Kazn3/Case7_Exoskeleton/CAD/CAD READ ME.md

Dit README-bestand geeft een overzicht van alle CAD-iteraties van het product.
Het doel is om duidelijk te tonen welke CAD-files bij welke iteratie horen, per onderdeel.

Het product bestaat uit:
  Onderdeel A: Main_Hub
  Onderdeel B: Hand_Link
  Onderdeel C: Lower_connector
  Bijkomende parts

```
/CAD_FILES
 ├── MAIN_HUB
 │    ├── MAIN_HUB
 │    |    ├── SERVO_MINI
 │    |    |    ├── LOBE_GEAR_2
 │    |    |    └── Single row radial deep groove ball bearing ISO 1002 11 4_826
 │    |    |         └── Single row radial deep groove ball bearing ISO 1002 11 4_826_PART_1 -5
 │    |    ├── GEARBOX
 │    |    ├── Single row radial deep groove ball bearing ISO 1002 11 4_826
 │    |    |    └── Single row radial deep groove ball bearing ISO 1002 11 4_826_PART_1 -5
 │    |    ├── HOUSING
 │    |    └── Hexalobular socket cheese head screw ISO 14579 M5x45
 │    ├── MAIN_HUB_2
 │    |    ├── SERVO_MINI
 │    |    |    ├── LOBE_GEAR_2
 │    |    |    └── Single row radial deep groove ball bearing ISO 1002 11 4_826
 │    |    |         └── Single row radial deep groove ball bearing ISO 1002 11 4_826_PART_1 -5
 │    |    ├── GEARBOX_2
 │    |    ├── Single row radial deep groove ball bearing ISO 1002 11 4_826
 │    |    |    └── Single row radial deep groove ball bearing ISO 1002 11 4_826_PART_1 -5
 │    |    ├── HOUSING_2
 │    |    ├── ARDUINO_NANO
 │    |    |    └── nano-board_step
 │    |    ├── HOUSING_2
 │    |    ├── BATTERY_3.7V
 │    |    ├── ARM
 │    |    ├── PCB
 │    |    ├── SPACER
 │    |    ├── Hexagon socket countersunk head screw ISO 10642 M5x16
 │    |    ├── Hexagon socket countersunk head screw ISO 10642 M5x45
 │    |    └── Hexalobular socket cheese head screw ISO 14579 M5x45
 │    ├── MAIN_HUB_3
 │    |    ├── SERVO_MINI
 │    |    |    ├── LOBE_GEAR_2
 │    |    |    └── Single row radial deep groove ball bearing ISO 1002 11 4_826
 │    |    |         └── Single row radial deep groove ball bearing ISO 1002 11 4_826_PART_1 -5
 │    |    ├── Single row radial deep groove ball bearing ISO 1002 11 4_826
 │    |    |    └── Single row radial deep groove ball bearing ISO 1002 11 4_826_PART_1 -5
 │    |    ├── PULLEY_MG
 │    |    |    ├── PULLEY_LINK_2
 │    |    |    └── SERVO_MINI
 │    |    |         ├── LOBE_GEAR_2
 │    |    |         └── Single row radial deep groove ball bearing ISO 1002 11 4_826
 │    |    |              └── Single row radial deep groove ball bearing ISO 1002 11 4_826_PART_1 -5
 │    |    ├── ROPE
 │    |    └── Hexalobular socket cheese head screw ISO 14579 M5x45
 │    ├── MAIN_HUB_4
 │    |    ├── SERVO_MINI
 │    |    |    ├── LOBE_GEAR_2
 │    |    |    └── Single row radial deep groove ball bearing ISO 1002 11 4_826
 │    |    |         └── Single row radial deep groove ball bearing ISO 1002 11 4_826_PART_1 -5
 │    |    ├── Single row radial deep groove ball bearing ISO 1002 11 4_826
 │    |    |    └── Single row radial deep groove ball bearing ISO 1002 11 4_826_PART_1 -5
 │    |    ├── Hexagon socket countersunk head screw ISO 10642 M5x16
 │    |    └── Hexagon socket countersunk head screw ISO 10642 M5x45
 │    ├── MAIN_HUB_5
 │    |    ├── SERVO
 │    |    |    ├── LEVER_CONNECTOR
 │    |    |    ├── LEVER
 │    |    |    ├── LEVER_2
 │    |    |    ├── Single row radial deep groove ball bearing ISO 1002 11 4_826
 │    |    |    |    └── Single row radial deep groove ball bearing ISO 1002 11 4_826_PART_1 -5
 │    |    |    └── LOBE_GEAR_2
 │    |    ├── CONNECTOR
 │    |    └── Hexagon socket countersunk head screw ISO 10642 M5x45
 │    └── MAIN_HUB_6
 │    |    ├── SERVO
 │    |    |    ├── LEVER_CONNECTOR
 │    |    |    ├── LEVER
 │    |    |    ├── LEVER_2
 │    |    |    ├── Single row radial deep groove ball bearing ISO 1002 11 4_826
 │    |    |    |    └── Single row radial deep groove ball bearing ISO 1002 11 4_826_PART_1 -5
 │    |    |    └── LOBE_GEAR_2
 │    |    ├── TOP_SHELL
 │    |    ├── BACK_PART
 │    |    ├── FRONT_PART
 │    |    ├── BATTERY_MOUNT
 │    |    └── Hexagon socket countersunk head screw ISO 10642 M5x45
 ├── LOWER_CONNECTOR
 │    └── Iteratie_01: LOWER_CONNECTOR
 ├── HAND_LINK
 |    ├── HAND_LINK
 |    ├── HAND_LINK_2
 |    ├── HAND_LINK_3
 |    ├── HAND_LINK_4
 |    ├── HAND_LINK_5
 |    ├── HAND_LINK_6
 |    ├── HAND_LINK_7
 |    ├── HAND_LINK_8
 |    └── HAND_LINK_9
 └── BIJKOMENDE PARTS
      ├── HAND_F1
      ├── HAND_PLACEHOLDER
      └── TEST_MAIN

De visuals zijn gemaakt in blender. 

/VIS_FILES
 └── EXPL_HUB_6
```
