Kazn3/Case7_Exoskeleton/(list of files, cad)

Other CAD files:
CAD/102 RESISTOR PACK_step.prt
CAD/15pin_header___step.prt
CAD/16mhz crystal - measured_step.prt
CAD/189 RESISTOR PACK_step.prt
CAD/2pin_header__02_step.prt
CAD/ARDUINO_NAN0.prt
CAD/BACK_PART.prt
CAD/BATTERY_3.7V.prt
CAD/BATTERY_MOUNT.prt
CAD/CONNECTOR.prt
CAD/FRONT_PART.prt
CAD/HAND_F1.prt
CAD/HAND_LINK_3.prt
CAD/HAND_LINK_4.prt
CAD/HAND_LINK_5.prt
CAD/HAND_LINK_6.prt
CAD/HAND_LINK_7.prt
CAD/HAND_LINK_8.prt
CAD/HAND_PLACEHOLDER.prt
CAD/HOUSING.prt
CAD/HOUSING_2.prt
CAD/Hexagon socket countersunk head screw ISO 10642 M5x16.prt
CAD/Hexagon socket countersunk head screw ISO 10642 M5x45.prt
CAD/Hexalobular socket cheese head screw ISO 14579 M3x20.prt
CAD/Hexalobular socket cheese head screw ISO 14579 M5x45.prt
CAD/LEVER.prt
CAD/LEVER_2.prt
CAD/LEVER_CONNECTOR.prt
CAD/LOBE_GEAR.prt
CAD/LOBE_GEAR_2.prt
CAD/LOBE_TEST.prt
CAD/LOWER_CONNECTOR.prt
CAD/MAIN_HUB.prt
CAD/MAIN_HUB_2.prt
CAD/MAIN_HUB_3.prt
CAD/MAIN_HUB_4.prt
CAD/MINI USB CONTACT_step.prt
CAD/MINIUSB - MEASURED_step.prt
CAD/MINIUSBCORE_step.prt
CAD/MINIUSBSHELL_step.prt
CAD/NANO DIODE_step.prt
CAD/PCB.prt
CAD/PULLEY_LINK.prt
CAD/PULLEY_LINK_2.prt
CAD/PULLEY_MG.prt
CAD/ROPE.prt
CAD/SERVO.prt
CAD/SERVO_MINI.prt
CAD/SPACER.prt
CAD/Single row radial deep groove ball bearing ISO 1002 11 4_826.prt
CAD/Single row radial deep groove ball bearing ISO 1002 11 4_826_PART1.prt
CAD/Single row radial deep groove ball bearing ISO 1002 11 4_826_PART2.prt
CAD/Single row radial deep groove ball bearing ISO 1002 11 4_826_PART3.prt
CAD/Single row radial deep groove ball bearing ISO 1002 11 4_826_PART4.prt
CAD/Single row radial deep groove ball bearing ISO 1002 11 4_826_PART5.prt
CAD/TEST_MAIN.prt
CAD/TOP_SHELL.prt
CAD/atmega328_step.prt
CAD/cap106C_step.prt
CAD/ftdi FT232rl_step.prt
CAD/led_step.prt
CAD/nano - reg_step.prt
CAD/nano-board_step.prt
CAD/reset button_step.prt
CAD/reset core_step.prt
CAD/reset shell_step.prt
CAD/smt_resistor222_step.prt
