Kazn3/Case7_Exoskeleton/(commit log)

2025-11-26 Create Arduino
2025-11-26 Update Arduino
2026-01-18 Create CAD READ ME
    basis CAD README
2026-01-18 Create CAD FILES
2026-01-18 Update CAD READ ME
2026-01-18 Rename CAD READ ME to CAD READ ME.md
2026-01-18 Rename CAD READ ME.md to CAD READ ME
2026-01-18 Fix formatting issues in CAD README.md
2026-01-18 Update CAD READ ME.md
2026-01-18 Expand CAD section with Main Hub iteration details
    Added detailed structure for Main Hub iterations in CAD section.
2026-01-18 Enhance README with table of contents and Arduino section
    Added table of contents and Arduino section to README.
2026-01-18 Revise section titles and add lower connector details
    Updated section titles and added new section for lower connector.
2026-01-18 Update Arduino section with file location
2026-01-18 Enhance README with component details
    Added descriptions for the main hub, lower connector, and hand link components, including details about their functionality and design.
2026-01-18 Document Arduino servo control setup and features
    Added detailed section about Arduino code for controlling 5 servo motors via a website using Bluetooth Low Energy (BLE), including features, required hardware, pin mapping, servo movement, available patterns, and possible expansions.
2026-01-18 Update README with cleat mechanism details
    Added a cleat mechanism to the design for easier wire tension adjustment.
2026-01-18 Update README with hand link details and file listings
    Removed velcro strip from hand link 6 for better flexibility and added details about the use of TPU material. Updated sections for hand links 7, 8, and 9 to include file listings.
